todbot/picotouch_grid/README.md

# picotouch_grid

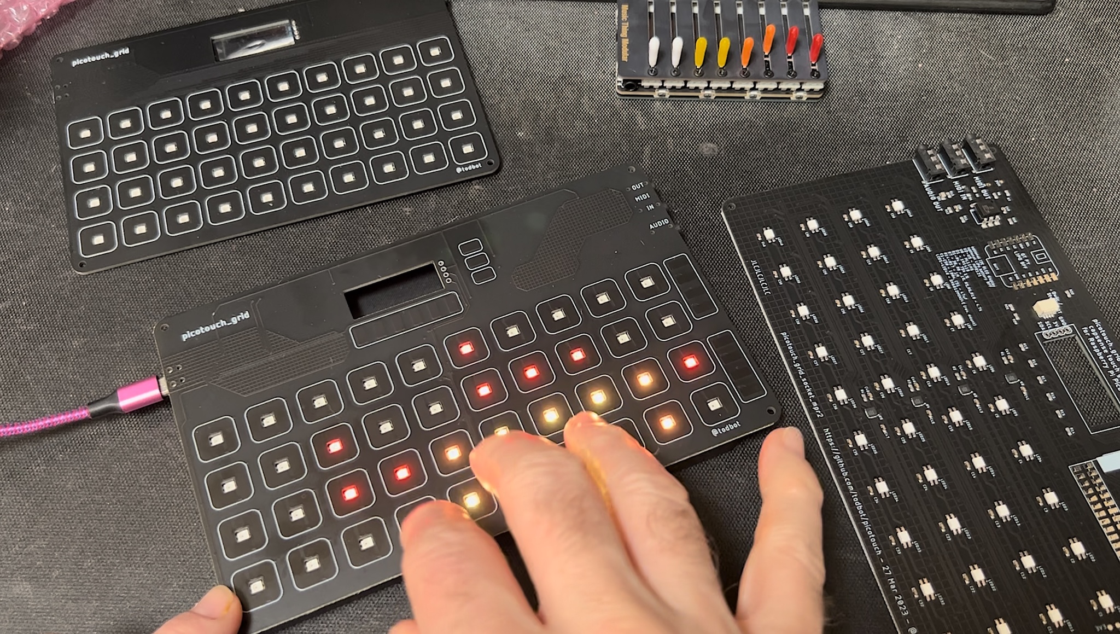
[picture p1: docs/picotouch_grids_test.jpg]


## Demo

https://github.com/user-attachments/assets/54ee2066-7102-474b-aefb-f99e8350b503

another on youtube:  https://www.youtube.com/watch?v=ulmvLfkXsHI

Watch the video (https://www.youtube.com/watch?v=ulmvLfkXsHI)
