todbot/picotouch_grid/hardware/picotouch_grid/README.md

Uses JLCPCB rules from https://github.com/labtroll/KiCad-DesignRules
