todbot/picotouch_grid/hardware/picotouch_grid/picotouch_grid.kicad_pcb

## KiCad design hardware/picotouch_grid/picotouch_grid.kicad_pcb (2026-10-17)

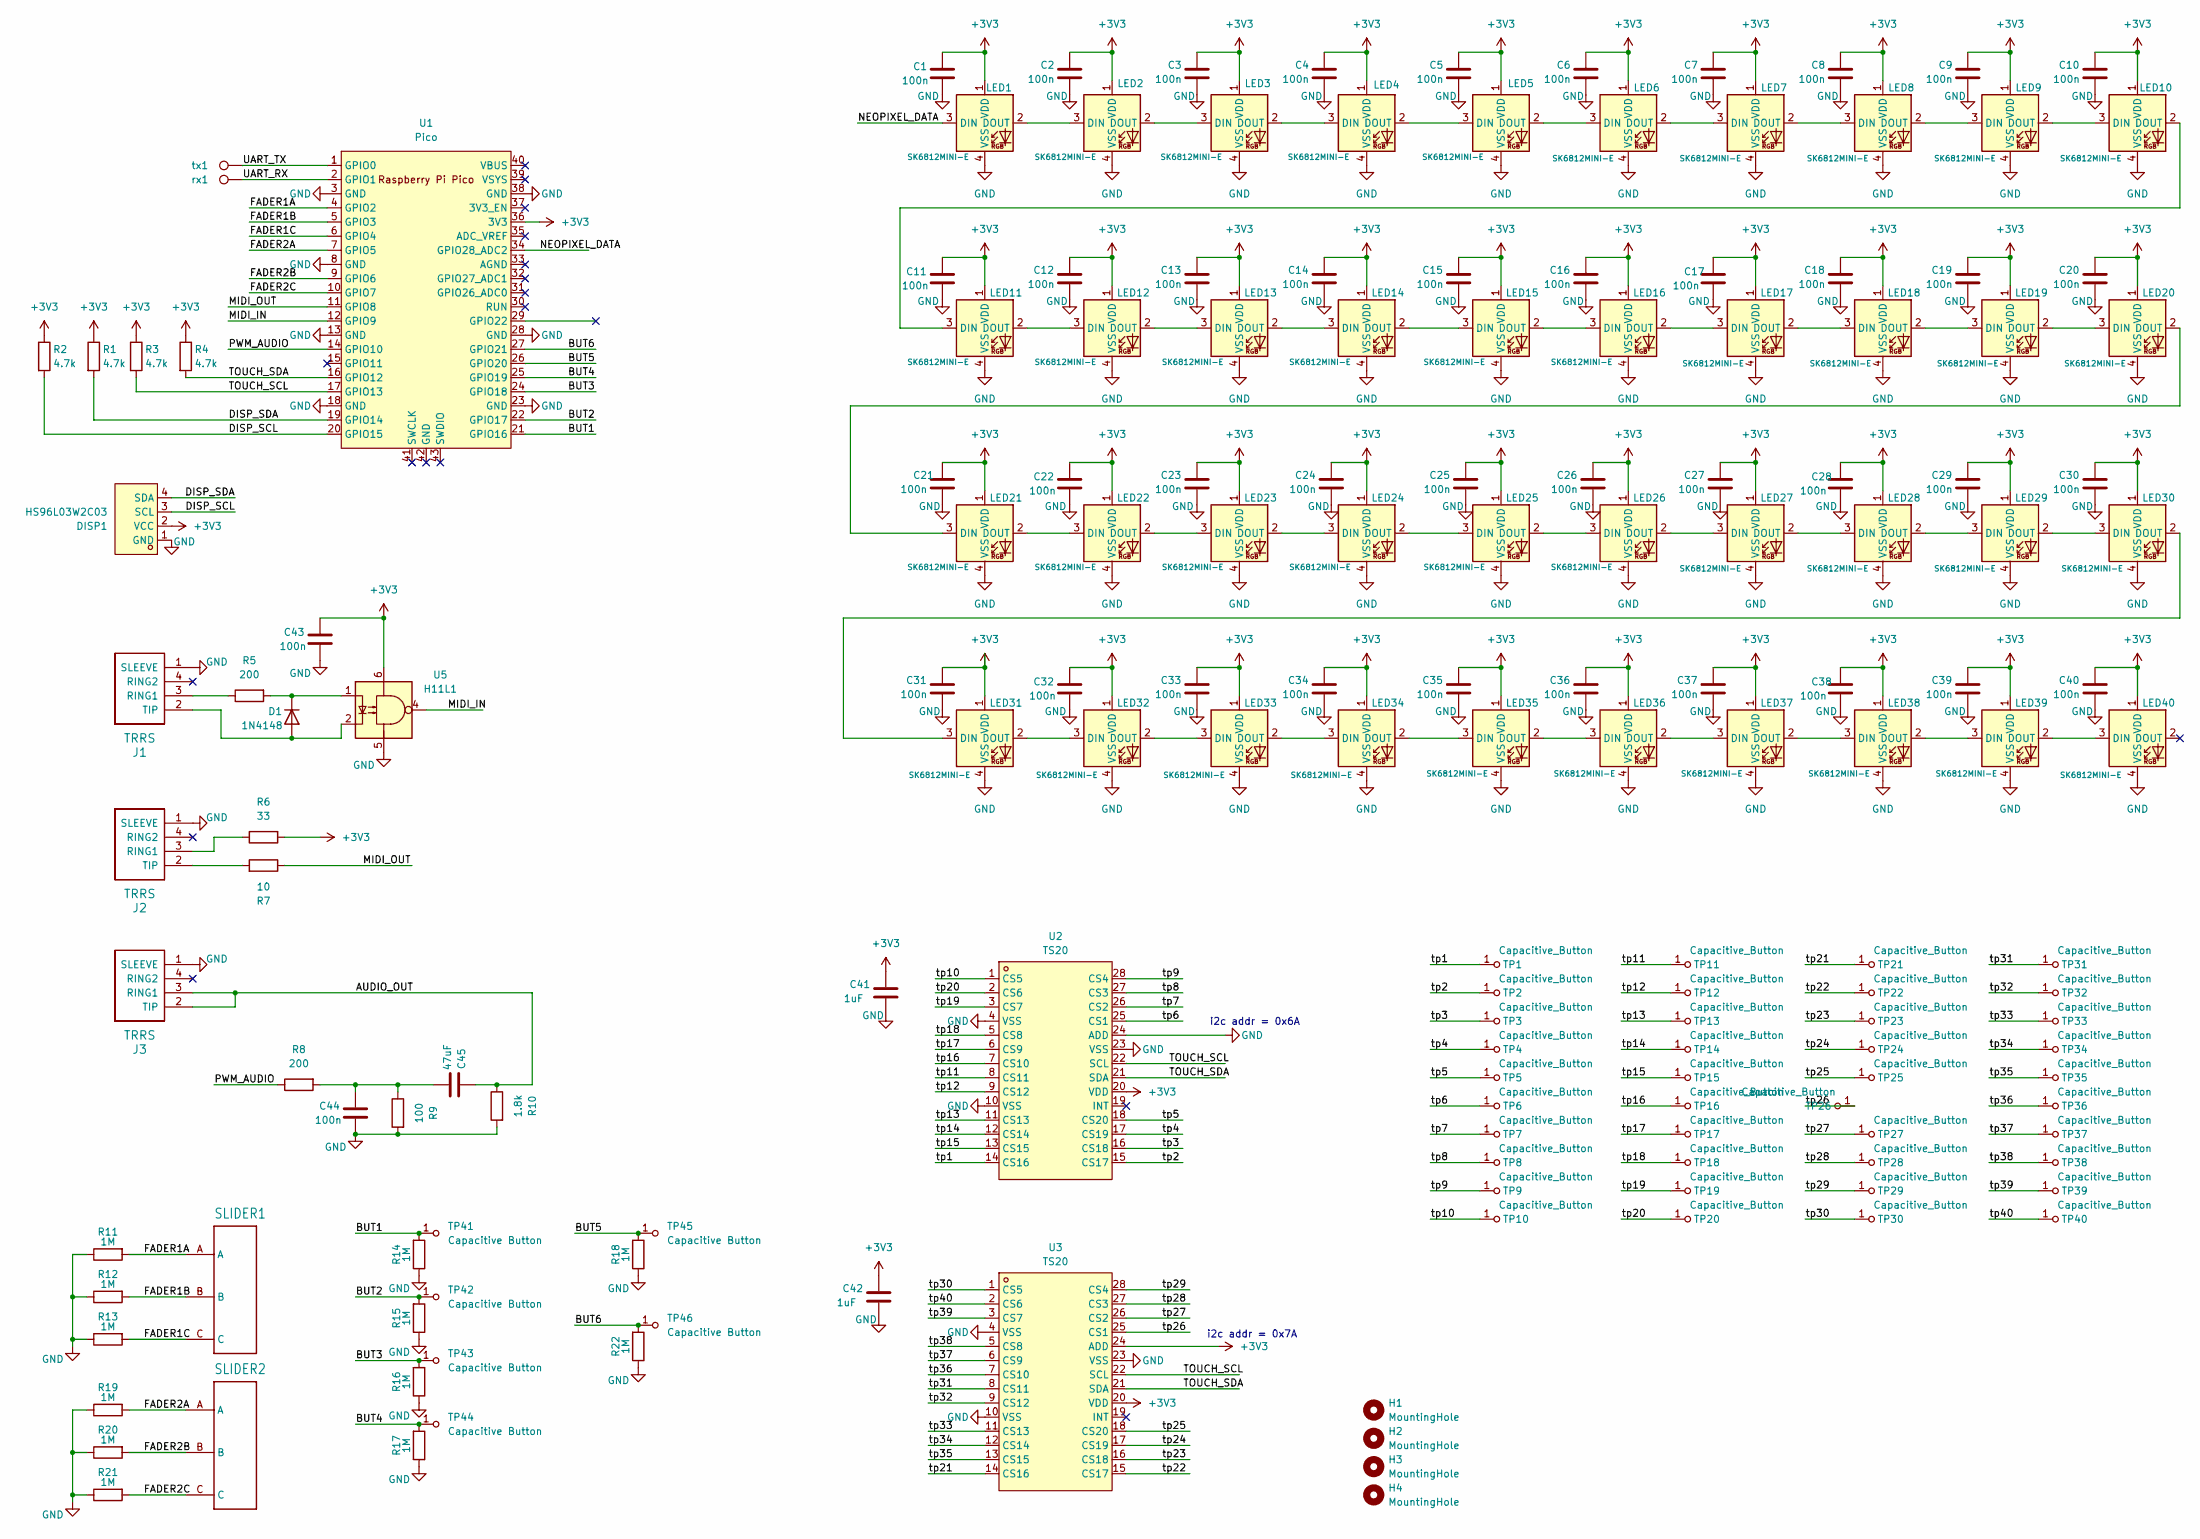
[picture p2: schematic picotouch_grid.kicad_sch]

Parts:
C1, C2, C3, C4, C5, C6, C7, C8, C9, C10, C11, C12, C13, C14, C15, C16, C17, C18, C19, C20, C21, C22, C23, C24, C25, C26, C27, C28, C29, C30, C31, C32, C33, C34, C35, C36, C37, C38, C39, C40, C43, C44: 100n; C_0603_1608Metric
C41, C42: 1uF; C_0603_1608Metric
C45: 47uF; C_0603_1608Metric
D1: 1N4148; D_SOD-123
DISP1: HS96L03W2C03; OLED-TH_under_fixed_L27.8-W27.2-P2.54_C9900033791; LCSC Part C5248080
H1, H2, H3, H4: MountingHole; MountingHole_2.7mm_M2.5
J1, J2, J3: TRRS; TRRS-PJ-320D
LED1, LED2, LED3, LED4, LED5, LED6, LED7, LED8, LED9, LED10, LED11, LED12, LED13, LED14, LED15, LED16, LED17, LED18, LED19, LED20, LED21, LED22, LED23, LED24, LED25, LED26, LED27, LED28, LED29, LED30, LED31, LED32, LED33, LED34, LED35, LED36, LED37, LED38, LED39, LED40: SK6812MINI-E; LED_6028R
R1, R2, R3, R4: 4.7k; R_0603_1608Metric
R5, R8: 200; R_0603_1608Metric
R6: 33; R_0603_1608Metric
R7: 10; R_0603_1608Metric
R9: 100; R_0603_1608Metric
R10: 1.8k; R_0603_1608Metric
R11, R12, R13, R14, R15, R16, R17, R18, R19, R20, R21, R22: 1M; R_0603_1608Metric
SLIDER1, SLIDER2: TOUCHSLIDER3_8x40B
TP1, TP2, TP3, TP4, TP5, TP6, TP7, TP8, TP9, TP10, TP11, TP12, TP13, TP14, TP15, TP16, TP17, TP18, TP19, TP20, TP21, TP22, TP23, TP24, TP25, TP26, TP27, TP28, TP29, TP30, TP31, TP32, TP33, TP34, TP35, TP36, TP37, TP38, TP39, TP40: Capacitive_Button; TOUCHPAD_KEY_0.5IN_LEDHOLE
TP41, TP42, TP43, TP44, TP45, TP46: Capacitive Button; Pad-CapacitiveTouch
U1: Pico; RPi_Pico_SMD
U2, U3: TS20; TSSOP-28_L9.7-W4.4-P0.65-LS6.4-BL; LCSC Part C95876
U5: H11L1; DIP-6_W8.89mm_SMDSocket_LongPads
rx1: rx; TestPoint_Pad_D2.0mm
tx1: tx; TestPoint_Pad_D2.0mm

Connections:
+3V3: C1.1, C2.1, C3.1, C4.1, C5.1, C6.1, C7.1, C8.1, C9.1, C10.1, C11.1, C12.1, C13.1, C14.1, C15.1, C16.1, C17.1, C18.1, C19.1, C20.1, C21.1, C22.1, C23.1, C24.1, C25.1, C26.1, C27.1, C28.1, C29.1, C30.1, C31.1, C32.1, C33.1, C34.1, C35.1, C36.1, C37.1, C38.1, C39.1, C40.1, C41.1, C42.1, C43.1, DISP1.2 (VCC), LED1.1 (VDD), LED2.1 (VDD), LED3.1 (VDD), LED4.1 (VDD), LED5.1 (VDD), LED6.1 (VDD), LED7.1 (VDD), LED8.1 (VDD), LED9.1 (VDD), LED10.1 (VDD), LED11.1 (VDD), LED12.1 (VDD), LED13.1 (VDD), LED14.1 (VDD), LED15.1 (VDD), LED16.1 (VDD), LED17.1 (VDD), LED18.1 (VDD), LED19.1 (VDD), LED20.1 (VDD), LED21.1 (VDD), LED22.1 (VDD), LED23.1 (VDD), LED24.1 (VDD), LED25.1 (VDD), LED26.1 (VDD), LED27.1 (VDD), LED28.1 (VDD), LED29.1 (VDD), LED30.1 (VDD), LED31.1 (VDD), LED32.1 (VDD), LED33.1 (VDD), LED34.1 (VDD), LED35.1 (VDD), LED36.1 (VDD), LED37.1 (VDD), LED38.1 (VDD), LED39.1 (VDD), LED40.1 (VDD), R1.1, R2.1, R3.1, R4.1, R6.2, U1.36 (3V3), U2.20 (VDD), U3.20 (VDD), U3.24 (ADD), U5.6
/AUDIO_OUT: C45.1, J3.2 (TIP), J3.3 (RING1), R10.1
/BUT1: R14.2, TP41.1 (A), U1.21 (GPIO16)
/BUT2: R15.2, TP42.1 (A), U1.22 (GPIO17)
/BUT3: R16.2, TP43.1 (A), U1.24 (GPIO18)
/BUT4: R17.2, TP44.1 (A), U1.25 (GPIO19)
/BUT5: R18.2, TP45.1 (A), U1.26 (GPIO20)
/BUT6: R22.2, TP46.1 (A), U1.27 (GPIO21)
/DISP_SCL: DISP1.3 (SCL), R2.2, U1.20 (GPIO15)
/DISP_SDA: DISP1.4 (SDA), R1.2, U1.19 (GPIO14)
/FADER1A: R11.2, SLIDER1.A, U1.4 (GPIO2)
/FADER1B: R12.2, SLIDER1.B, U1.5 (GPIO3)
/FADER1C: R13.2, SLIDER1.C, U1.6 (GPIO4)
/FADER2A: R19.2, SLIDER2.A, U1.7 (GPIO5)
/FADER2B: R20.2, SLIDER2.B, U1.9 (GPIO6)
/FADER2C: R21.2, SLIDER2.C, U1.10 (GPIO7)
/MIDI_IN: U1.12 (GPIO9), U5.4
/MIDI_OUT: R7.1, U1.11 (GPIO8)
/NEOPIXEL_DATA: LED1.3 (DIN), U1.34 (GPIO28_ADC2)
/PWM_AUDIO: R8.1, U1.14 (GPIO10)
/TOUCH_SCL: R3.2, U1.17 (GPIO13), U2.22 (SCL), U3.22 (SCL)
/TOUCH_SDA: R4.2, U1.16 (GPIO12), U2.21 (SDA), U3.21 (SDA)
/UART_RX: U1.2 (GPIO1), rx1.1
/UART_TX: U1.1 (GPIO0), tx1.1
/tp1: TP1.1 (A), U2.14 (CS16)
/tp2: TP2.1 (A), U2.15 (CS17)
/tp3: TP3.1 (A), U2.16 (CS18)
/tp4: TP4.1 (A), U2.17 (CS19)
/tp5: TP5.1 (A), U2.18 (CS20)
/tp6: TP6.1 (A), U2.25 (CS1)
/tp7: TP7.1 (A), U2.26 (CS2)
/tp8: TP8.1 (A), U2.27 (CS3)
/tp9: TP9.1 (A), U2.28 (CS4)
/tp10: TP10.1 (A), U2.1 (CS5)
/tp11: TP11.1 (A), U2.8 (CS11)
/tp12: TP12.1 (A), U2.9 (CS12)
/tp13: TP13.1 (A), U2.11 (CS13)
/tp14: TP14.1 (A), U2.12 (CS14)
/tp15: TP15.1 (A), U2.13 (CS15)
/tp16: TP16.1 (A), U2.7 (CS10)
/tp17: TP17.1 (A), U2.6 (CS9)
/tp18: TP18.1 (A), U2.5 (CS8)
/tp19: TP19.1 (A), U2.3 (CS7)
/tp20: TP20.1 (A), U2.2 (CS6)
/tp21: TP21.1 (A), U3.14 (CS16)
/tp22: TP22.1 (A), U3.15 (CS17)
/tp23: TP23.1 (A), U3.16 (CS18)
/tp24: TP24.1 (A), U3.17 (CS19)
/tp25: TP25.1 (A), U3.18 (CS20)
/tp26: TP26.1 (A), U3.25 (CS1)
/tp27: TP27.1 (A), U3.26 (CS2)
/tp28: TP28.1 (A), U3.27 (CS3)
/tp29: TP29.1 (A), U3.28 (CS4)
/tp30: TP30.1 (A), U3.1 (CS5)
/tp31: TP31.1 (A), U3.8 (CS11)
/tp32: TP32.1 (A), U3.9 (CS12)
/tp33: TP33.1 (A), U3.11 (CS13)
/tp34: TP34.1 (A), U3.12 (CS14)
/tp35: TP35.1 (A), U3.13 (CS15)
/tp36: TP36.1 (A), U3.7 (CS10)
/tp37: TP37.1 (A), U3.6 (CS9)
/tp38: TP38.1 (A), U3.5 (CS8)
/tp39: TP39.1 (A), U3.3 (CS7)
/tp40: TP40.1 (A), U3.2 (CS6)
GND: C1.2, C2.2, C3.2, C4.2, C5.2, C6.2, C7.2, C8.2, C9.2, C10.2, C11.2, C12.2, C13.2, C14.2, C15.2, C16.2, C17.2, C18.2, C19.2, C20.2, C21.2, C22.2, C23.2, C24.2, C25.2, C26.2, C27.2, C28.2, C29.2, C30.2, C31.2, C32.2, C33.2, C34.2, C35.2, C36.2, C37.2, C38.2, C39.2, C40.2, C41.2, C42.2, C43.2, C44.2, DISP1.1 (GND), J1.1 (SLEEVE), J2.1 (SLEEVE), J3.1 (SLEEVE), LED1.4 (VSS), LED2.4 (VSS), LED3.4 (VSS), LED4.4 (VSS), LED5.4 (VSS), LED6.4 (VSS), LED7.4 (VSS), LED8.4 (VSS), LED9.4 (VSS), LED10.4 (VSS), LED11.4 (VSS), LED12.4 (VSS), LED13.4 (VSS), LED14.4 (VSS), LED15.4 (VSS), LED16.4 (VSS), LED17.4 (VSS), LED18.4 (VSS), LED19.4 (VSS), LED20.4 (VSS), LED21.4 (VSS), LED22.4 (VSS), LED23.4 (VSS), LED24.4 (VSS), LED25.4 (VSS), LED26.4 (VSS), LED27.4 (VSS), LED28.4 (VSS), LED29.4 (VSS), LED30.4 (VSS), LED31.4 (VSS), LED32.4 (VSS), LED33.4 (VSS), LED34.4 (VSS), LED35.4 (VSS), LED36.4 (VSS), LED37.4 (VSS), LED38.4 (VSS), LED39.4 (VSS), LED40.4 (VSS), R9.2, R10.2, R11.1, R12.1, R13.1, R14.1, R15.1, R16.1, R17.1, R18.1, R19.1, R20.1, R21.1, R22.1, U1.3 (GND), U1.8 (GND), U1.13 (GND), U1.18 (GND), U1.23 (GND), U1.28 (GND), U1.38 (GND), U2.4 (VSS), U2.10 (VSS), U2.23 (VSS), U2.24 (ADD), U3.4 (VSS), U3.10 (VSS), U3.23 (VSS), U5.5
unnamed: C44.1, C45.2, R8.2, R9.1
unnamed: D1.2 (A), J1.2 (TIP), U5.2
unnamed: D1.1 (K), R5.2, U5.1
unnamed: J1.3 (RING1), R5.1
unnamed: J2.3 (RING1), R6.1
unnamed: J2.2 (TIP), R7.2
unnamed: LED1.2 (DOUT), LED2.3 (DIN)
unnamed: LED2.2 (DOUT), LED3.3 (DIN)
unnamed: LED3.2 (DOUT), LED4.3 (DIN)
unnamed: LED4.2 (DOUT), LED5.3 (DIN)
unnamed: LED5.2 (DOUT), LED6.3 (DIN)
unnamed: LED6.2 (DOUT), LED7.3 (DIN)
unnamed: LED7.2 (DOUT), LED8.3 (DIN)
unnamed: LED8.2 (DOUT), LED9.3 (DIN)
unnamed: LED9.2 (DOUT), LED10.3 (DIN)
unnamed: LED10.2 (DOUT), LED11.3 (DIN)
unnamed: LED11.2 (DOUT), LED12.3 (DIN)
unnamed: LED12.2 (DOUT), LED13.3 (DIN)
unnamed: LED13.2 (DOUT), LED14.3 (DIN)
unnamed: LED14.2 (DOUT), LED15.3 (DIN)
unnamed: LED15.2 (DOUT), LED16.3 (DIN)
unnamed: LED16.2 (DOUT), LED17.3 (DIN)
unnamed: LED17.2 (DOUT), LED18.3 (DIN)
unnamed: LED18.2 (DOUT), LED19.3 (DIN)
unnamed: LED19.2 (DOUT), LED20.3 (DIN)
unnamed: LED20.2 (DOUT), LED21.3 (DIN)
unnamed: LED21.2 (DOUT), LED22.3 (DIN)
unnamed: LED22.2 (DOUT), LED23.3 (DIN)
unnamed: LED23.2 (DOUT), LED24.3 (DIN)
unnamed: LED24.2 (DOUT), LED25.3 (DIN)
unnamed: LED25.2 (DOUT), LED26.3 (DIN)
unnamed: LED26.2 (DOUT), LED27.3 (DIN)
unnamed: LED27.2 (DOUT), LED28.3 (DIN)
unnamed: LED28.2 (DOUT), LED29.3 (DIN)
unnamed: LED29.2 (DOUT), LED30.3 (DIN)
unnamed: LED30.2 (DOUT), LED31.3 (DIN)
unnamed: LED31.2 (DOUT), LED32.3 (DIN)
unnamed: LED32.2 (DOUT), LED33.3 (DIN)
unnamed: LED33.2 (DOUT), LED34.3 (DIN)
unnamed: LED34.2 (DOUT), LED35.3 (DIN)
unnamed: LED35.2 (DOUT), LED36.3 (DIN)
unnamed: LED36.2 (DOUT), LED37.3 (DIN)
unnamed: LED37.2 (DOUT), LED38.3 (DIN)
unnamed: LED38.2 (DOUT), LED39.3 (DIN)
unnamed: LED39.2 (DOUT), LED40.3 (DIN)

Notes on the sheet:
i2c addr = 0x7A
i2c addr = 0x6A

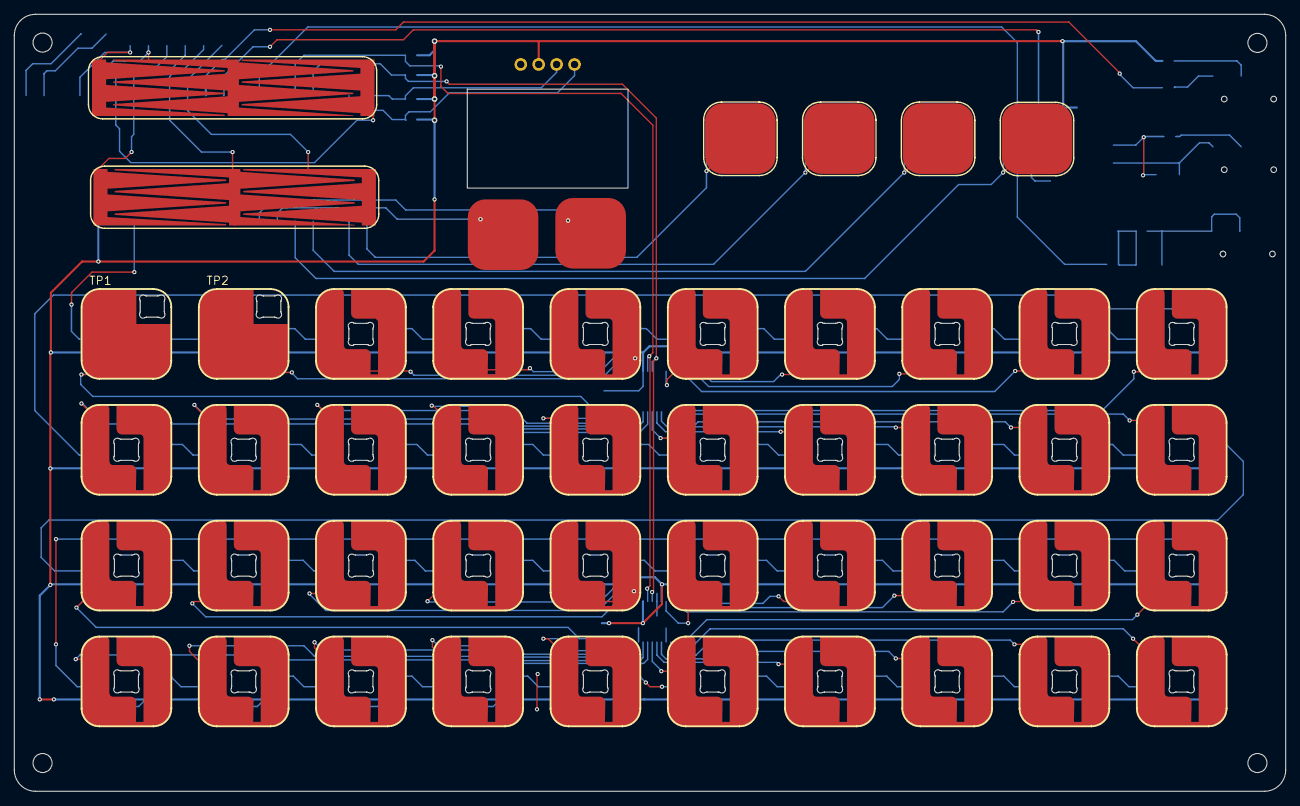
[picture p3: board picotouch_grid.kicad_pcb from above]

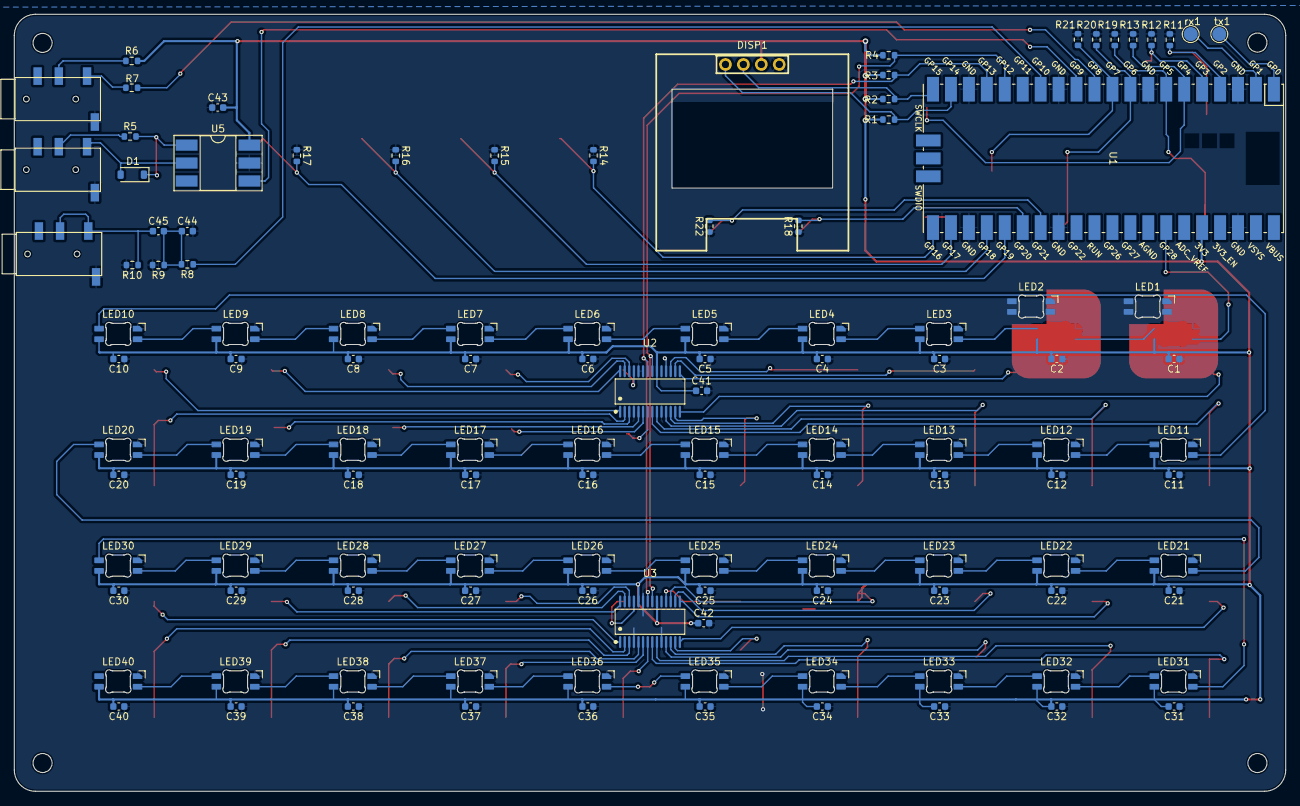
[picture p4: board picotouch_grid.kicad_pcb from below]

Board: 2 copper layers, 180.0 x 110.0 mm, 170 parts (117 on the bottom side), 110 nets.
