todbot/picotouch_grid/(commit log)

2024-03-18 made some pcb progress from old picotouch_grid_mpr board in Eagle in picotouch repo
    [picotouch_grid.kicad_pcb, picotouch_grid.kicad_sch]
2024-03-19 more pcb routing done
    [picotouch_grid.kicad_pcb, picotouch_grid.kicad_sch]
2024-03-19 pads mostly routed
    [picotouch_grid.kicad_pcb, picotouch_grid.kicad_sch]
2024-03-19 pcb captouch routing passes DRC
    [picotouch_grid.kicad_pcb]
2024-03-19 pcb DRC, with footprints updated (why was this needed)
    [picotouch_grid.kicad_pcb]
2024-03-19 added jlcpcb dru rules from "KiCad-DesignRules"
    [picotouch_grid.kicad_pcb, picotouch_grid.kicad_sch]
2024-03-20 pcb: added midi in/out, pwm audio out
    [picotouch_grid.kicad_pcb, picotouch_grid.kicad_sch]
2024-03-20 pcb: add more buttons, clean up layout of sch & pcb
    [picotouch_grid.kicad_pcb, picotouch_grid.kicad_sch]
2024-03-21 pcb: tune button layout
    [picotouch_grid.kicad_pcb, picotouch_grid.kicad_sch]
2024-03-21 pcb: another fader, i2c trace reorg
    [picotouch_grid.kicad_pcb, picotouch_grid.kicad_sch]
2024-03-22 pcb: button layout tune
    [picotouch_grid.kicad_pcb, picotouch_grid.kicad_sch]
2024-04-23 getting back into this, updated some stuff, getting lots of ERC, got some power pins wrong?
    [picotouch_grid.kicad_pcb, picotouch_grid.kicad_sch]
